hagleitn/nun-radio/(threads)

Thread 1 (2015-10-25):

Throttle "cruise" control

marksev1, 2015-10-25:
Great project you have here! I got a feature request, for example if I were to have throttle on accelerometer Y-axis, it would be nice to lock current throttle value with a button combo. So one could still move hand around on Y-axis and throttle wouldnt change. Then when I would want to change throttle i would press some button. Basically a throttle hold / cruise control function. Thanks

Closed 2015-11-19.

Thread 2 (2015-10-26):

Some compilation trouble :)

marksev1, 2015-10-26:
Hello I have some compilation trouble (using arduino ide 1.0.5). I just imported all the files into the ide. When I compile I get following error:

In file included from Adafruit_SSD1306.cpp:24:0:
Adafruit_SSD1306.h:31:17: fatal error: SPI.h: No such file or directory
 #include <SPI.h>
                 ^
compilation terminated.

-------
I have SPI.h included in my library and I also dragged it into the ide, but it still outputs same error. Can you help? Thanks.

-----

Actually also other include issues, can you help me out how to do it most efficently on Windows? (since that makefile only works on linux)

Closed 2015-11-19.
