hagleitn/nun-radio/WiiChuck.h

/**
 * This file is an adaptation of the code by these authors:
 * Tod E. Kurt, http://todbot.com/blog/
 *
 * The Wii Nunchuck reading code is taken from Windmeadow Labs
 * http://www.windmeadow.com/node/42
 *
 * Conversion to Arduino 1.0 by Danjovic
 * http://hotbit.blogspot.com
 *
 * Included the Fix from Martin Peris by Leopold Klimesch
 * http://blog.martinperis.com/2011/04/arduino-wiichuck.html
 *
 *
 */

#ifndef WiiChuck_h
#define WiiChuck_h

#include "Arduino.h"
#include <Wire.h>
#include <math.h>

// these may need to be adjusted for each nunchuck for calibration
#define ZEROX 510
#define ZEROY 490
#define ZEROZ 460
#define RADIUS 210  // probably pretty universal

#define DEFAULT_ZERO_JOY_X 127
#define DEFAULT_ZERO_JOY_Y 127

#define MAX_JOY 255
#define MAX_ANGLE 1023

//Set the power pins for the wiichuck, otherwise it will not be powered up
#ifdef PORTC2
#define pwrpin PORTC3
#define gndpin PORTC2
#endif


class WiiChuck {
 private:
  uint8_t cnt;
  uint8_t status[6] = {}; // array to store wiichuck output
  uint8_t averageCounter;
  //int accelArray[3][AVERAGE_N];  // X,Y,Z
  int i;
  int total;
  uint8_t zeroJoyX;   // these are about where mine are
  uint8_t zeroJoyY; // use calibrateJoy when the stick is at zero to correct
  int lastJoyX;
  int lastJoyY;
  int angles[3] = {};

  bool lastZ, lastC;


 public:

  uint8_t joyX;
  uint8_t joyY;

  bool buttonZ;
  bool buttonC;

  bool notConnected() {
    // all max or all 0 indicate problem
    // this happens with the wireless nunchuck
    // before connection is established
    return
      (joyX == MAX_JOY &&
       joyY == MAX_JOY &&
       angles[0] == MAX_ANGLE &&
       angles[1] == MAX_ANGLE &&
       angles[2] == MAX_ANGLE)
      || (joyX == 0 &&
	  joyY == 0 &&
	  angles[0] == 0 &&
	  angles[1] == 0 &&
	  angles [1] == 0);
  }

  void begin() {

#ifdef PORTC2
    //Set power pins
    DDRC |= _BV(pwrpin) | _BV(gndpin);
    PORTC &=~ _BV(gndpin);
    PORTC |=  _BV(pwrpin);
#endif

    delay(100);  // wait for things to stabilize

    //send initialization handshake
    Wire.begin();
    delay(1);

    cnt = 0;
    averageCounter = 0;

    zeroJoyX = DEFAULT_ZERO_JOY_X;
    zeroJoyY = DEFAULT_ZERO_JOY_Y;

    // instead of the common 0x40 -> 0x00 initialization, we
    // use 0xF0 -> 0x55 followed by 0xFB -> 0x00.
    // this lets us use 3rd party nunchucks (like cheap $4 ebay ones)
    // while still letting us use official oness.
    // only side effect is that we no longer need to decode bytes in _nunchuk_decode_byte
    // see http://www.arduino.cc/cgi-bin/yabb2/YaBB.pl?num=1264805255
    //
    do {
      delay(100);
      Wire.beginTransmission(0x52);       // device address
      Wire.write(0xF0);
      Wire.write(0x55);
      Wire.endTransmission();
      delay(30);
      Wire.beginTransmission(0x52);
      Wire.write(0xFB);
      Wire.write((uint8_t)0x00);
      Wire.endTransmission();
      delay(30);
      Wire.beginTransmission(0x52);
      Wire.write(0xFA);
      Wire.endTransmission();
      delay(30);

      update();
    } while (notConnected());
  }

  void calibrateJoy() {
    zeroJoyX = joyX;
    zeroJoyY = joyY;
  }

  void update() {

    Wire.requestFrom(0x52, 6); // request data from nunchuck
    while (Wire.available ()) {
      // receive byte as an integer
      status[cnt++] = _nunchuk_decode_byte (Wire.read());
    }

    if (cnt > 5) {
      lastZ = buttonZ;
      lastC = buttonC;
      lastJoyX = readJoyX();
      lastJoyY = readJoyY();
      //averageCounter ++;
      //if (averageCounter >= AVERAGE_N)
      //    averageCounter = 0;

      cnt = 0;
      joyX = (status[0]);
      joyY = (status[1]);
      for (i = 0; i < 3; i++)
        //accelArray[i][averageCounter] = ((int)status[i+2] << 2) + ((status[5] & (B00000011 << ((i+1)*2) ) >> ((i+1)*2)));
        angles[i] = (status[i+2] << 2) + ((status[5] & (B00000011 << ((i+1)*2) ) >> ((i+1)*2)));

      //accelYArray[averageCounter] = ((int)status[3] << 2) + ((status[5] & B00110000) >> 4);
      //accelZArray[averageCounter] = ((int)status[4] << 2) + ((status[5] & B11000000) >> 6);

      buttonZ = !( status[5] & B00000001);
      buttonC = !((status[5] & B00000010) >> 1);
    }
    _send_zero(); // send the request for next bytes
  }

  float readAccelX() {
    // total = 0; // accelArray[xyz][averageCounter] * FAST_WEIGHT;
    return (float)angles[0] - ZEROX;
  }
  float readAccelY() {
    // total = 0; // accelArray[xyz][averageCounter] * FAST_WEIGHT;
    return (float)angles[1] - ZEROY;
  }
  float readAccelZ() {
    // total = 0; // accelArray[xyz][averageCounter] * FAST_WEIGHT;
    return (float)angles[2] - ZEROZ;
  }

  bool zPressed() {
    return (buttonZ && ! lastZ);
  }
  bool cPressed() {
    return (buttonC && ! lastC);
  }

  // for using the joystick like a directional button
  bool rightJoy(int thresh=60) {
    return (readJoyX() > thresh and lastJoyX <= thresh);
  }

  // for using the joystick like a directional button
  bool leftJoy(int thresh=60) {
    return (readJoyX() < -thresh and lastJoyX >= -thresh);
  }


  int readJoyX() {
    return (int) joyX - zeroJoyX;
  }

  int readJoyY() {
    return (int)joyY - zeroJoyY;
  }


  // R, the radius, generally hovers around 210 (at least it does with mine)
  // int R() {
  //     return sqrt(readAccelX() * readAccelX() +readAccelY() * readAccelY() + readAccelZ() * readAccelZ());
  // }


  // returns roll degrees
  int readRoll() {
    return (int)(atan2(readAccelX(),readAccelZ())/ M_PI * 180.0);
  }

  // returns pitch in degrees
  int readPitch() {
    return (int) (acos(readAccelY()/RADIUS)/ M_PI * 180.0);  // optionally swap 'RADIUS' for 'R()'
  }

 private:
  uint8_t _nunchuk_decode_byte (uint8_t x)
  {
    //decode is only necessary with certain initializations
    // x = (x ^ 0x17) + 0x17;
    return x;
  }

  void _send_zero()
  {
    Wire.beginTransmission (0x52);      // transmit to device 0x52
    Wire.write ((uint8_t)0x00);         // sends one byte
    Wire.endTransmission ();    // stop transmitting
  }

};

#endif
