hagleitn/nun-radio/RCEncoder.h

// RCEncoder.H

#ifndef RCEncoder_h
#define RCEncoder_h

#include "Arduino.h"

#ifdef __cplusplus
extern "C"{
#endif


#define ledTest1 8
#define ledTest2 9

#define NBR_OF_CHANNELS  5
#define MIN_CHANNEL_PULSE 800  // 1ms
#define MID_CHANNEL_PULSE 1300  // 1.5ms
#define MAX_CHANNEL_PULSE 1800  // 2 ms
#define INTER_CHAN_DELAY  200   // 200 microseconds
#define FRAME_RATE        20000 // 20 ms
#define SYNC_PULSE_WIDTH (FRAME_RATE - (NBR_OF_CHANNELS * (MID_CHANNEL_PULSE + INTER_CHAN_DELAY)))
#define MS_TO_TICKS(_ms)  ((_ms) * 2)  // todo, use macro here

  void encoderBegin(byte pin);
  void encoderWrite(byte channel, int microseconds);

#ifdef __cplusplus
} // extern "C"
#endif

#endif
