hagleitn/nun-radio/(commit log)

2015-07-11 graphical representation of volts and signal strength
2015-07-11 fix both button presses
    [LCD.h, nunradio.ino]
2015-07-13 fix byte div problem
    [LCD.cpp]
2015-07-17 fix for wireless chuck
    [WiiChuck.h, nunradio.ino]
2015-07-22 fix wireless nunchuck
2015-07-29 switch from float to int for size
2015-07-30 fixes for int based expo
    [LCD.cpp, ModelRegistry.h, Radio.h]
2015-07-30 dual rates + calibration
